rac2030/breakout-boards/README.md

# breakout-boards
Various breakoutboards for electronic components I play with
