rac2030/breakout-boards/ublox_NINA-W102/README.md

# ublox NINA-W102 breakout for breadboard prototyping
Project page with more information and background: http://rac.su/ninab

Hackaday Project entry: https://hackaday.io/project/151749-ublox-nina-w102-minimal-breakout

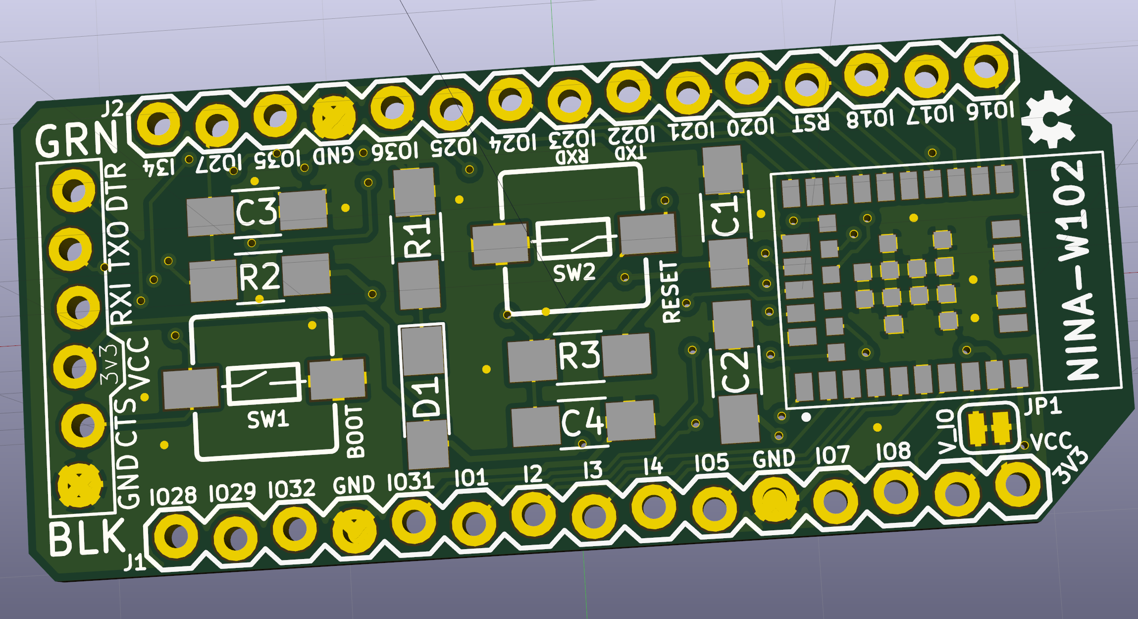
[picture p1: ublox_NINA-W102/images/NINA-W102_minimal_breakout-PCB.rev.0.3-3D-TOP.png]
3D Rendering

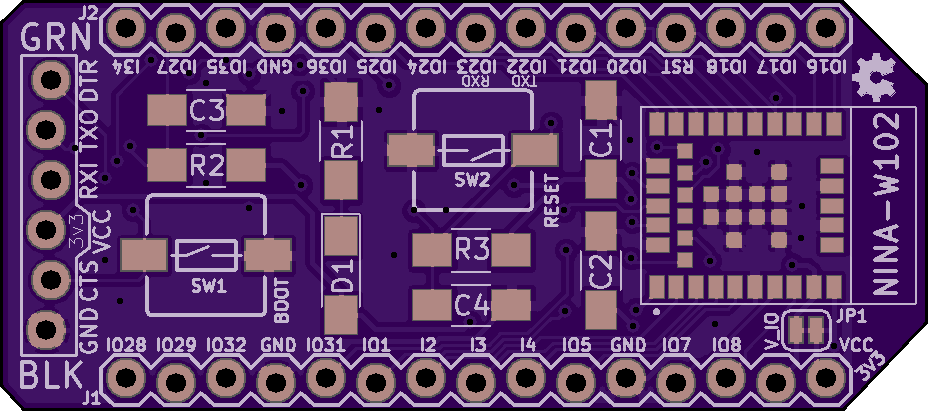
[picture p2: ublox_NINA-W102/images/NINA-W102_minimal_breakout-PCB.rev.0.3-OSHPark-TOP.png]
OSHPark TOP

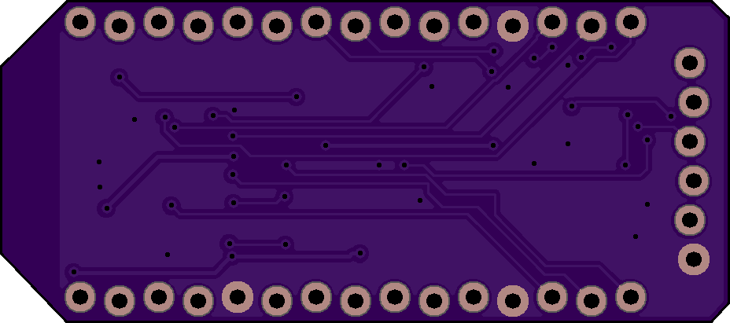
[picture p3: ublox_NINA-W102/images/NINA-W102_minimal_breakout-PCB.rev.0.3-OSHPark-BOTTOM.png]
OSHPark BOTTOM
