rac2030/breakout-boards/FPC-DIP_4PIN/README.md

# FPC connector breakout for breadboard prototyping
Created to play with Sensirion sensor samples on a Flex PCB for working on the software while the board design is still in progress. It is used with SMT FPC flip type connector from Ali ([Product I ordered](https://www.aliexpress.com/item/50pcs-FFC-FPC-Connector-4Pin-pitch-1-0mm-Flip-Type-Bottom-Contact/32655674440.html)) with 1.0mm pitch.
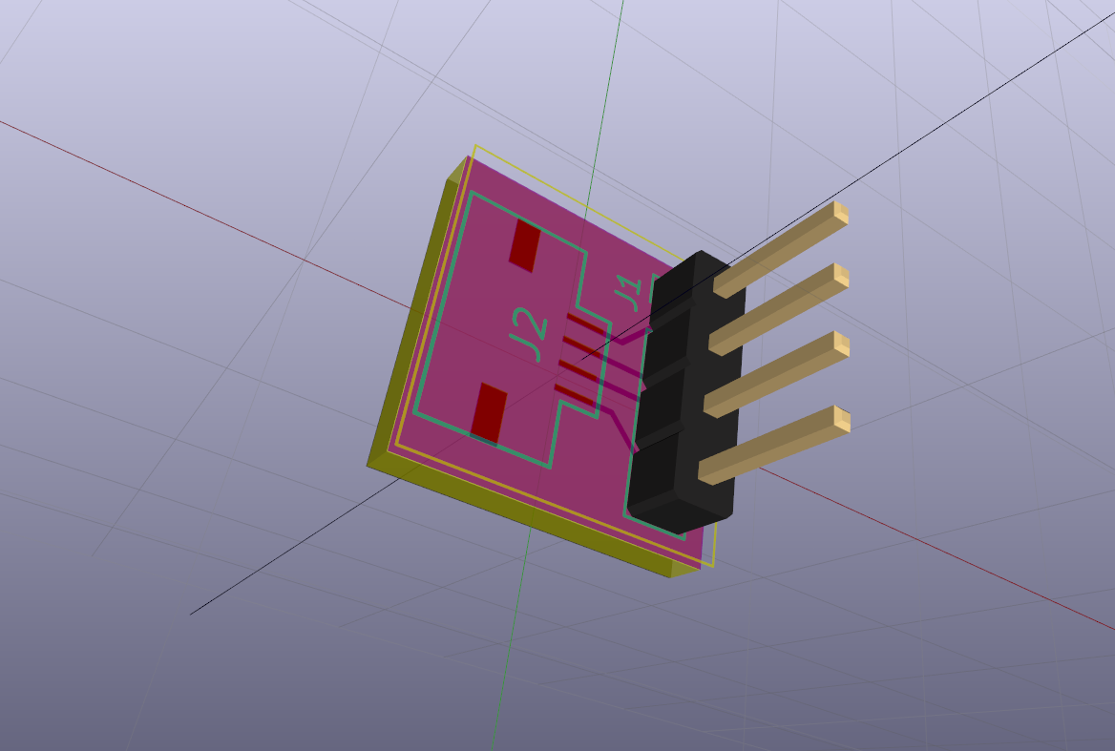
[picture p4: FPC-DIP_4PIN/FPC-DIP_4PIN.png]
3D Rendering


Rev. 0.1:
