rac2030/breakout-boards/ublox_NINA-W102/images/NINA-W102_minimal_breakout-PCB.rev.0.4-DIMENSION.png

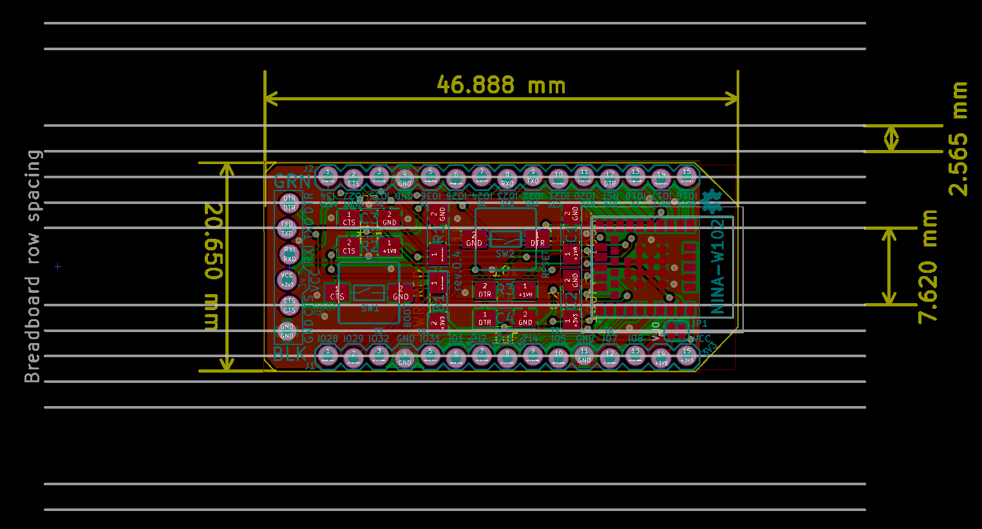
ublox_NINA-W102/images/NINA-W102_minimal_breakout-PCB.rev.0.4-DIMENSION.png
