rac2030/breakout-boards/ublox_NINA-W102/silkscreen/duck-tape-approved.png

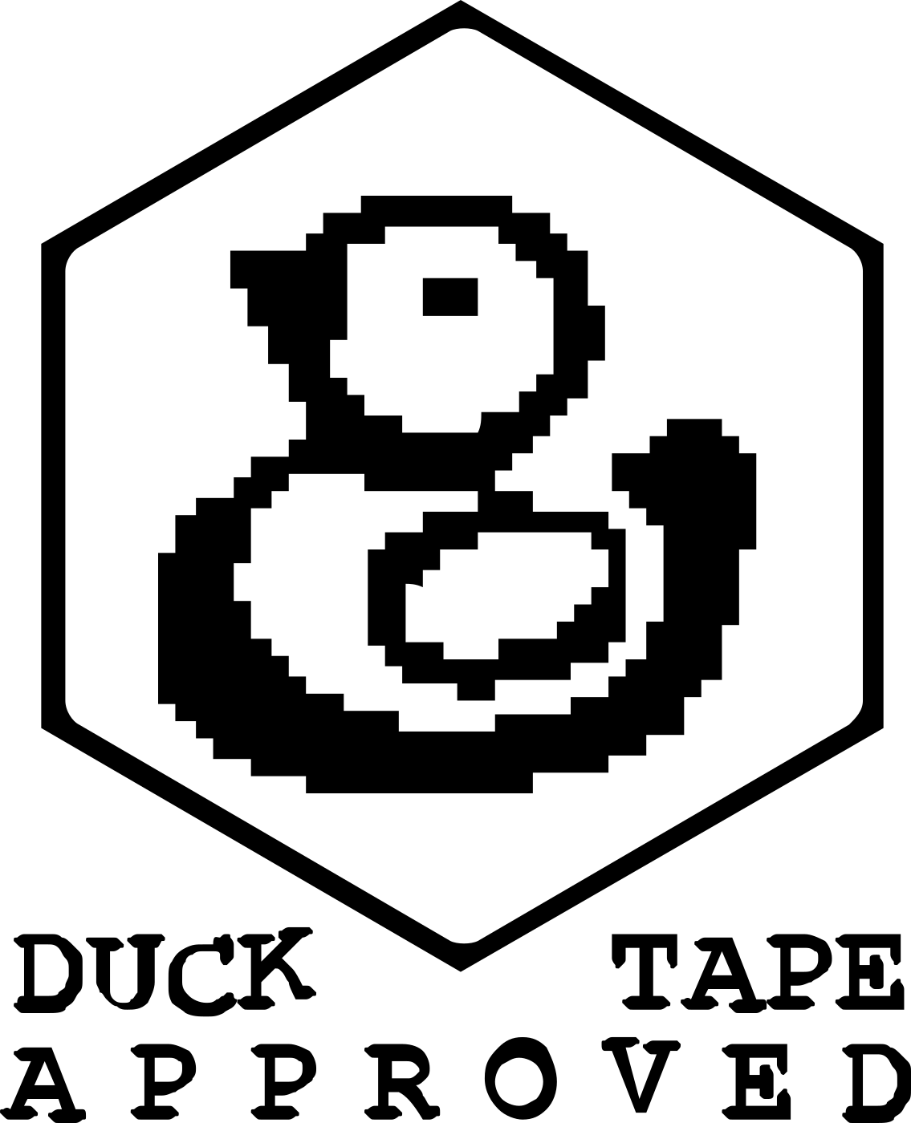
ublox_NINA-W102/silkscreen/duck-tape-approved.png
