rac2030/breakout-boards/ublox_NINA-W102/pinout/pinout-diagram.pdf

# http://rac.su/ninab CTS TXD RXD

### NINA-W102 Breakout

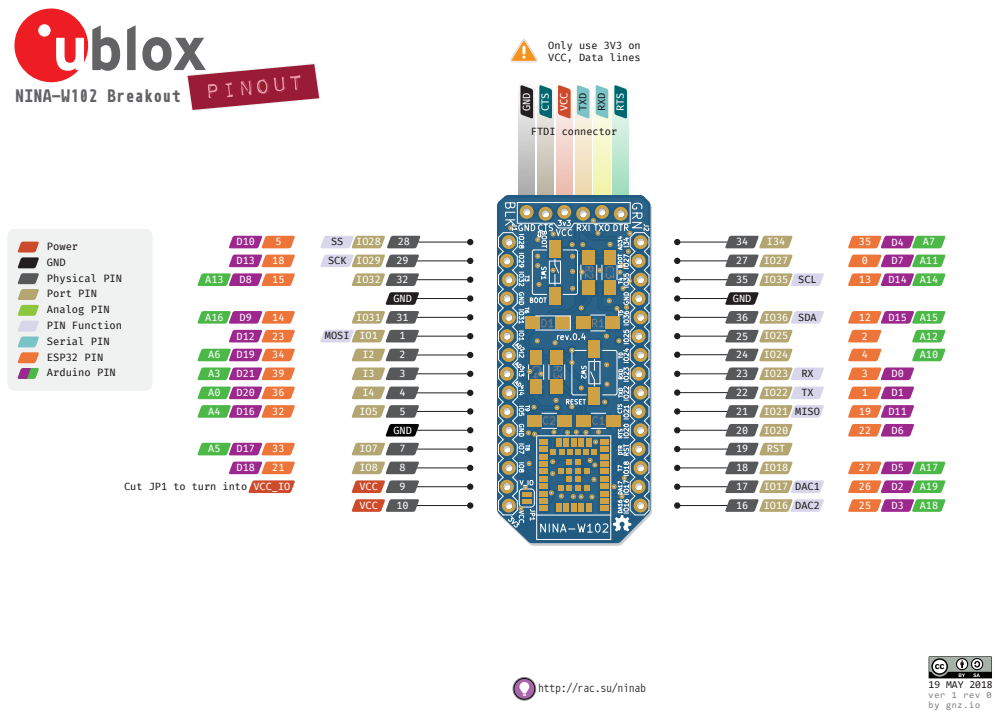
[picture p8: page 1]

Cut JP1 to turn into VCC_IO
