rac2030/breakout-boards/ublox_NINA-W102/NINA-W102_minimal_breakout-rev.0.5.pdf

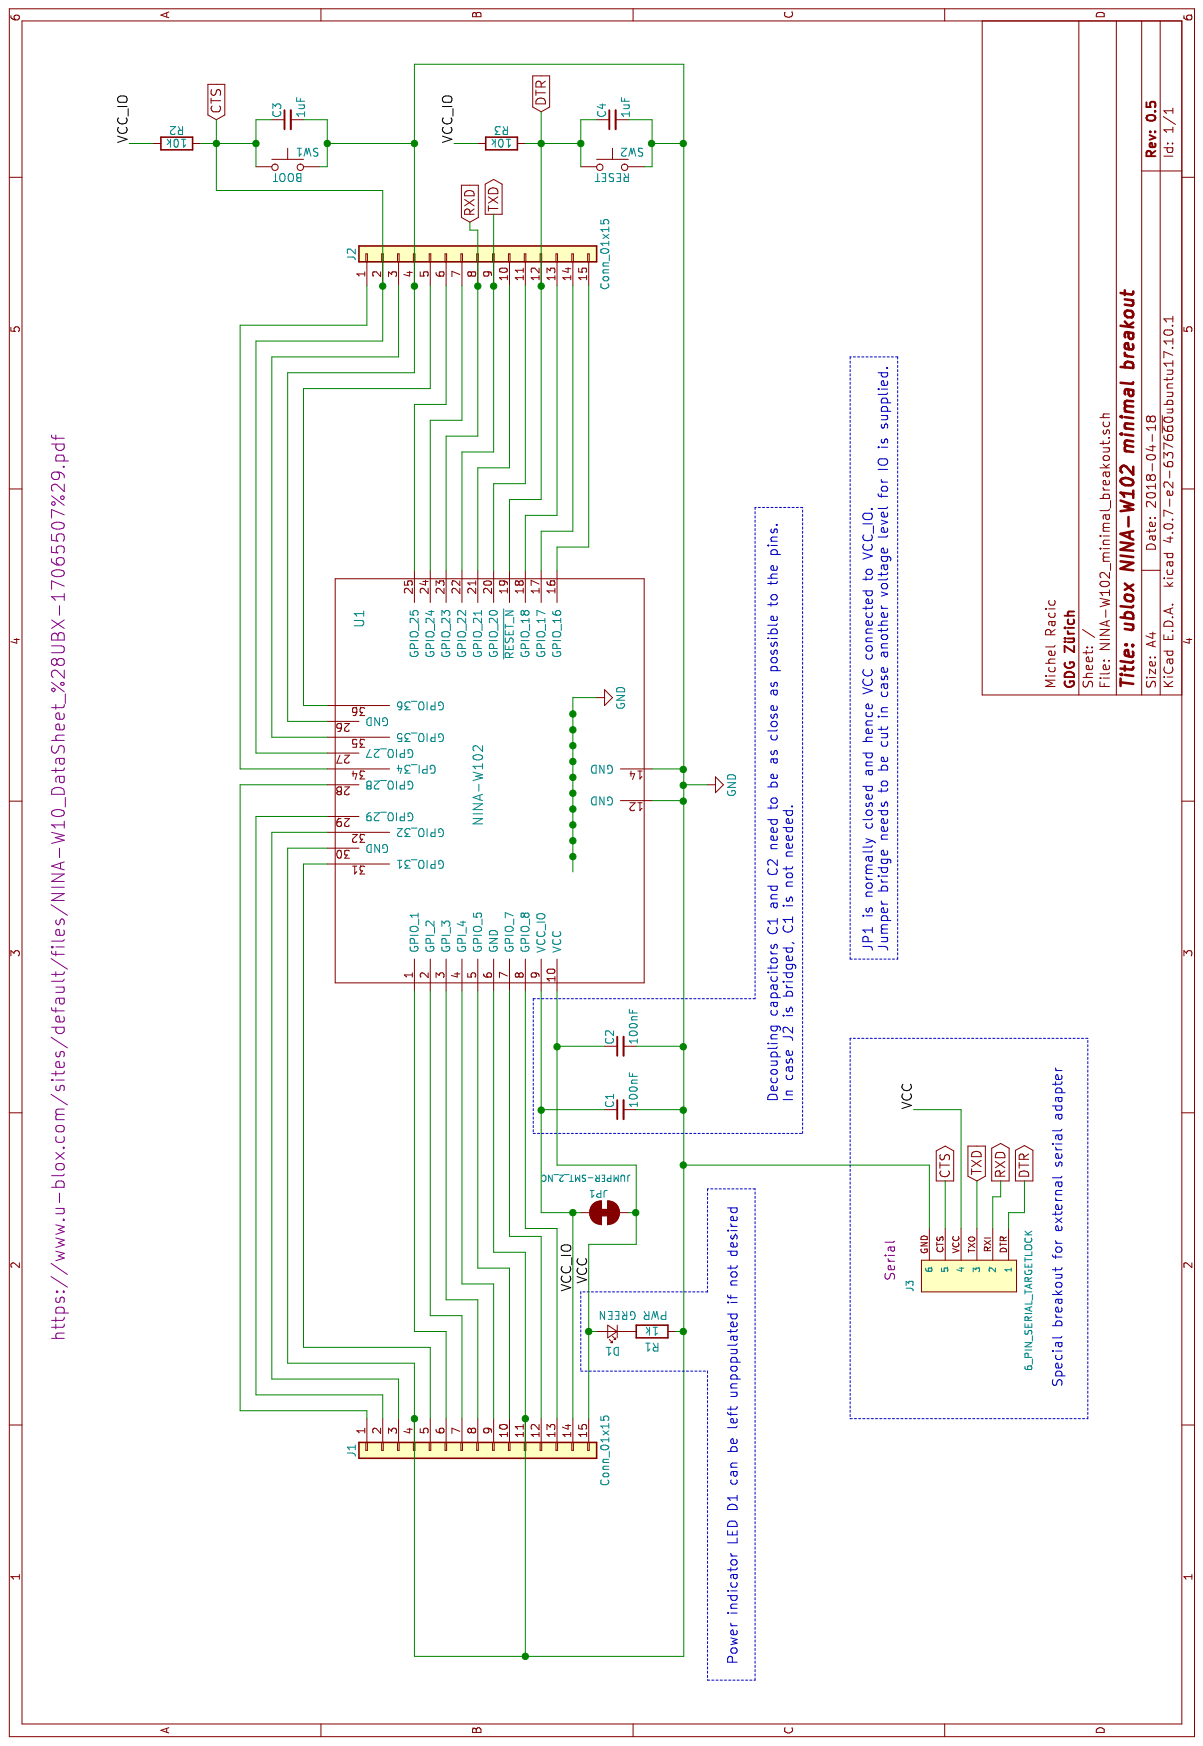
[picture p9: page 1]
