rac2030/breakout-boards/ublox_NINA-W102/NINA-W102_minimal_breakout-rev.0.4-PCB.pdf

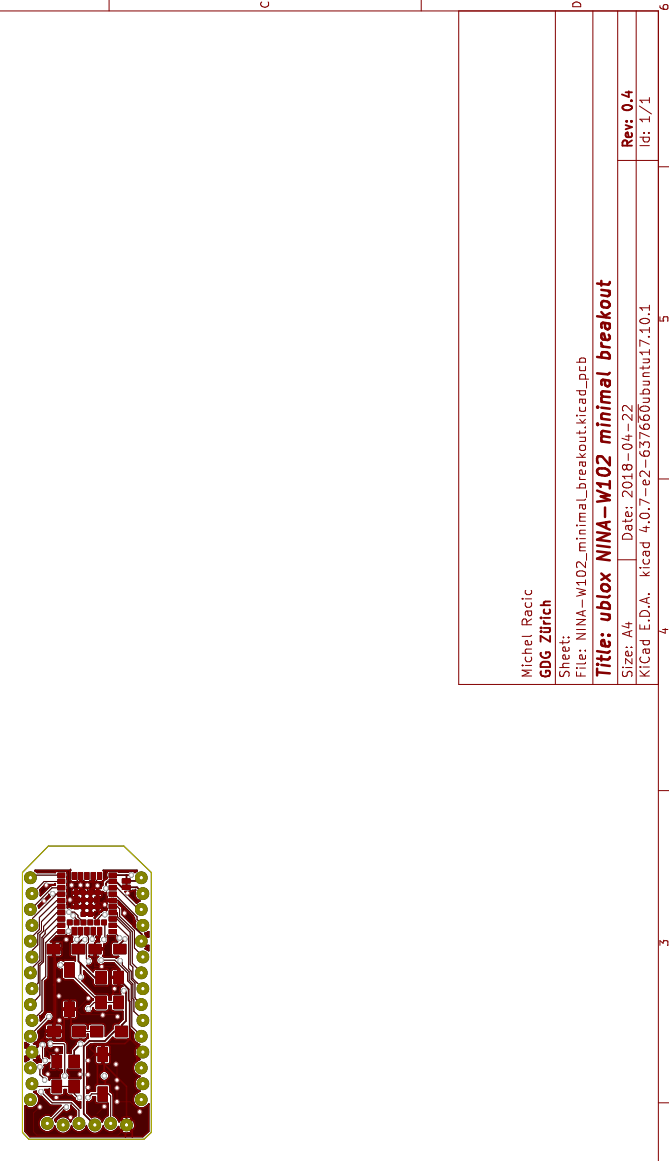
[picture p10: page 1]

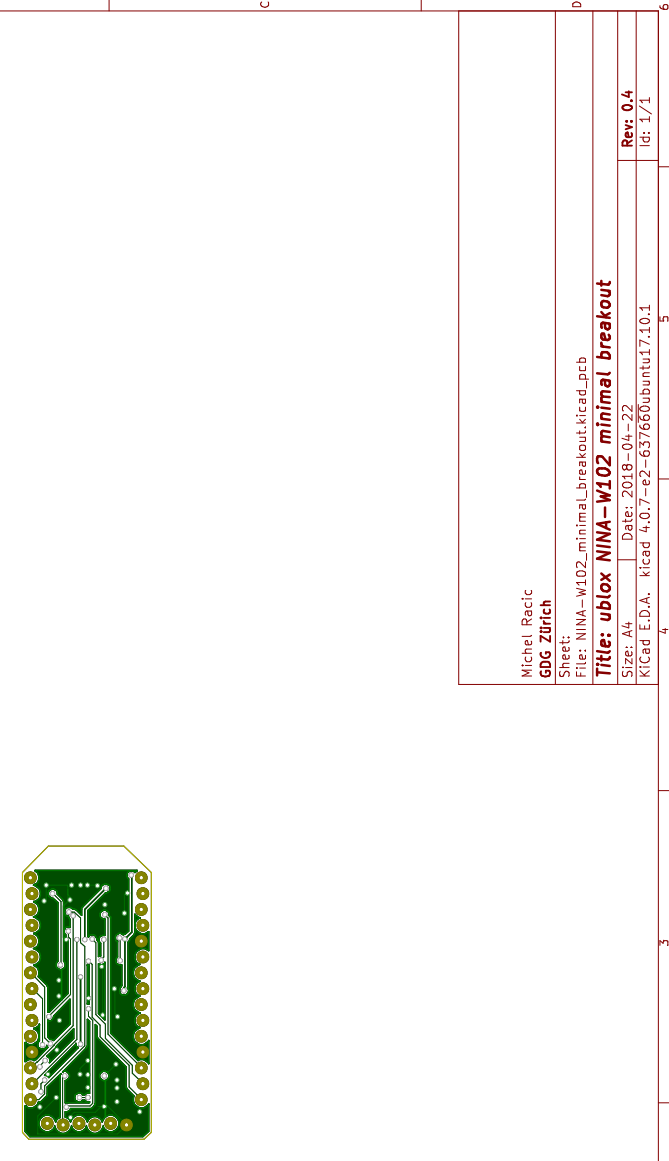
[picture p11: page 2]

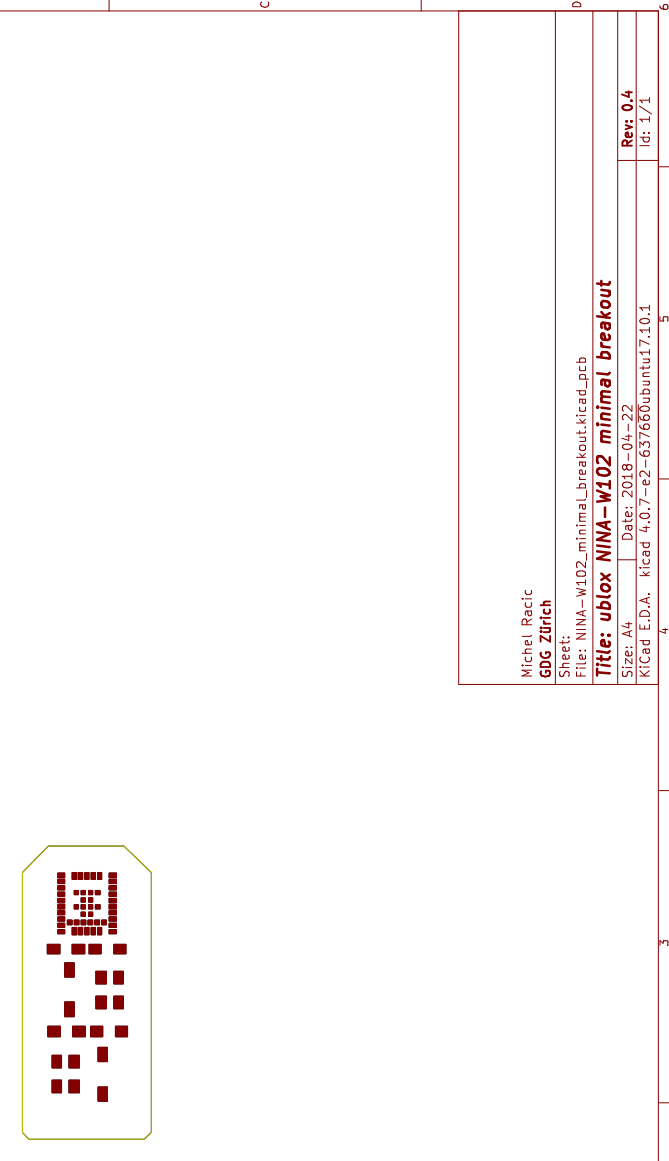
[picture p12: page 3]

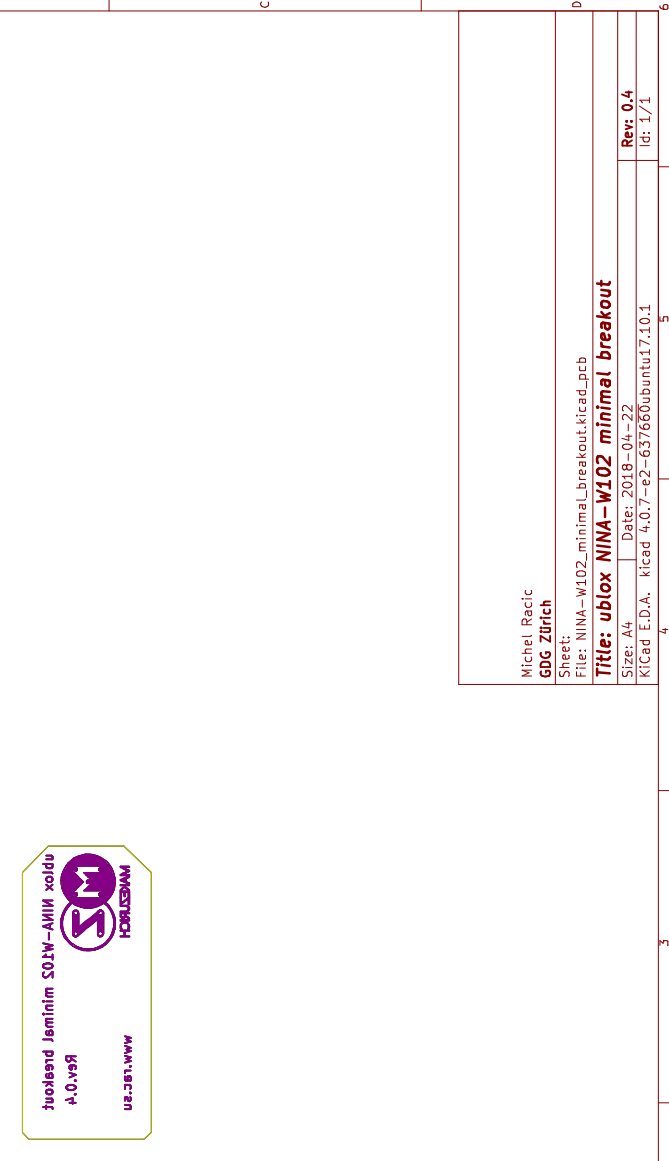
[picture p13: page 4]

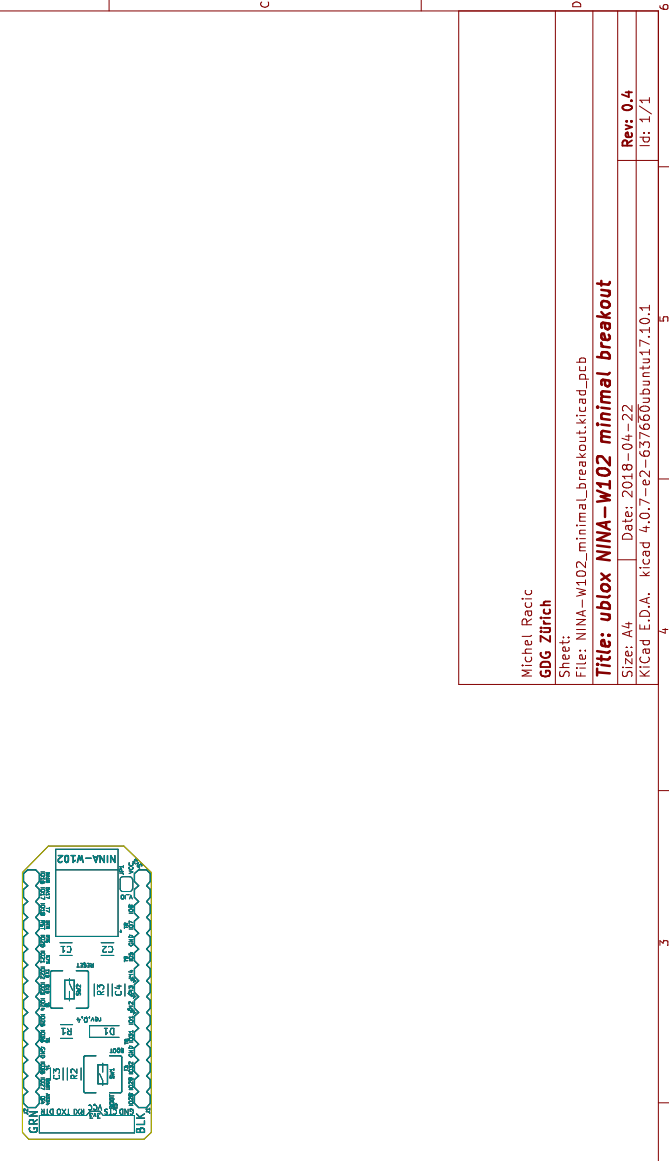
[picture p14: page 5]

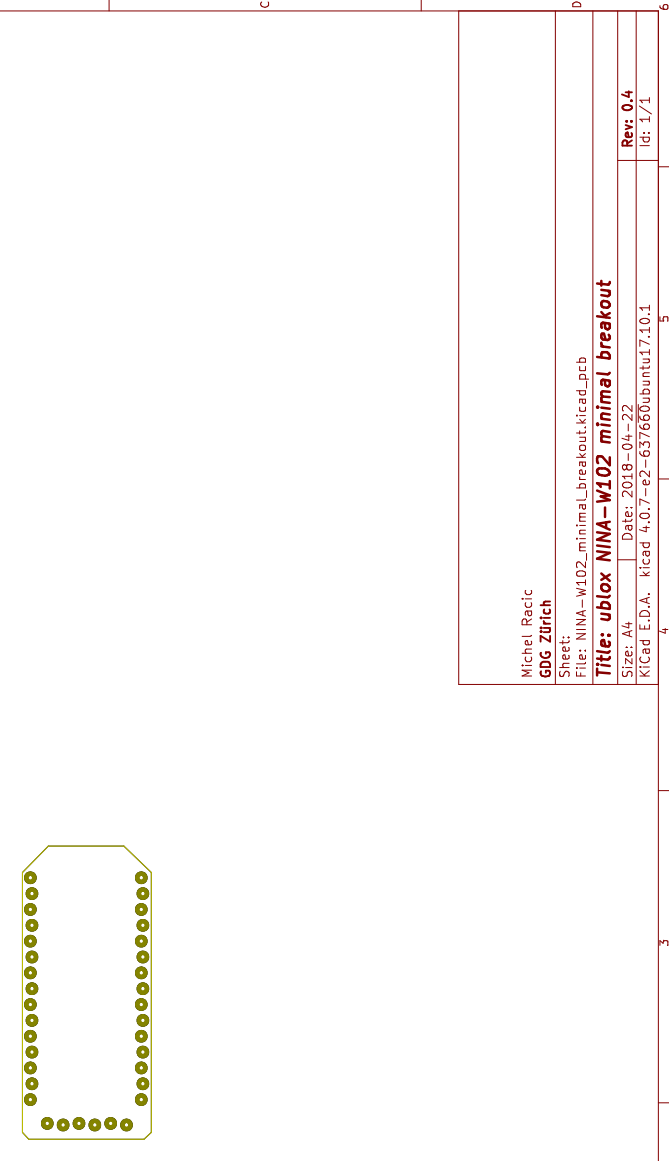
[picture p15: page 6]

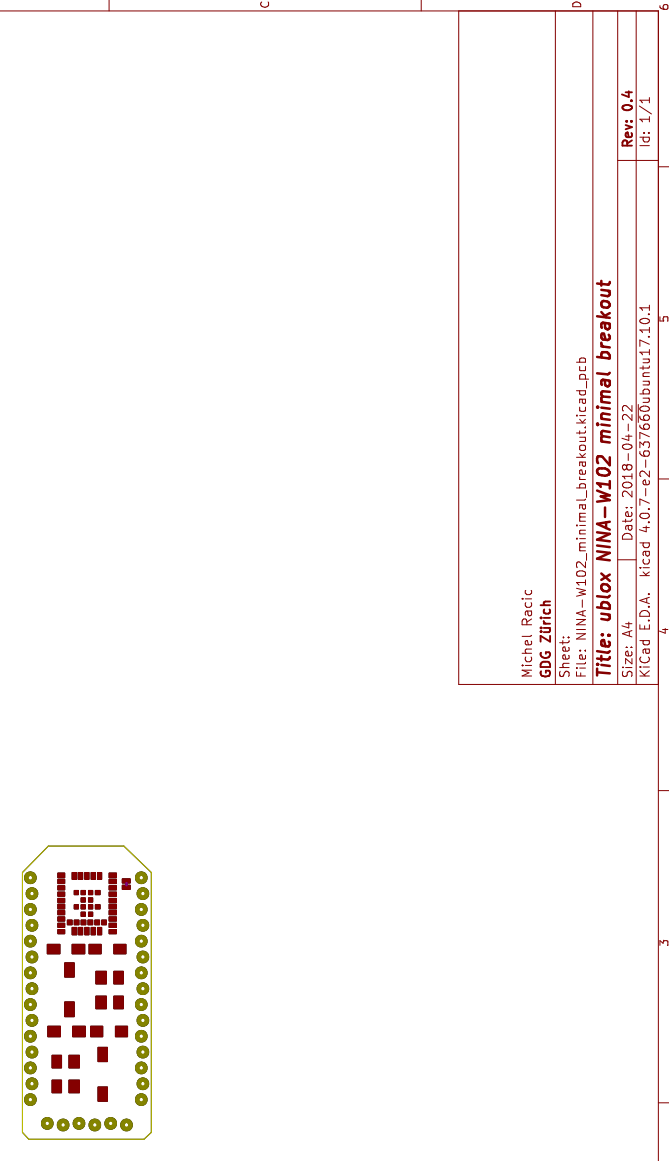
[picture p16: page 7]

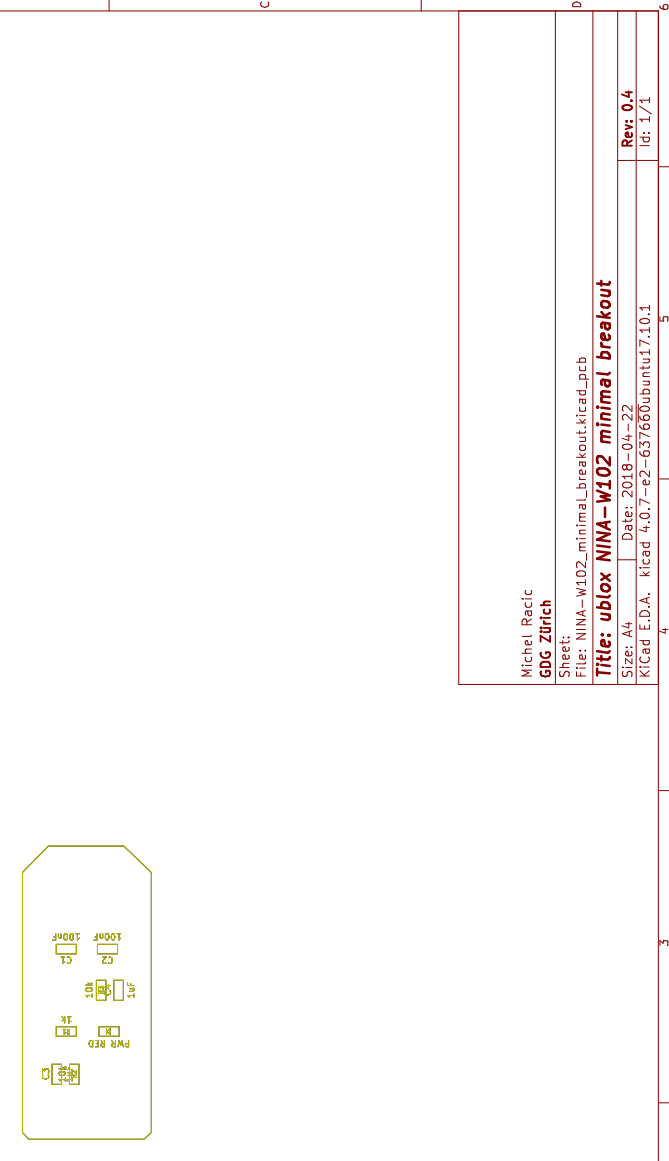
[picture p17: page 8]
