rac2030/breakout-boards/ublox_NINA-W102/NINA-W102_minimal_breakout-rev.0.4.pdf

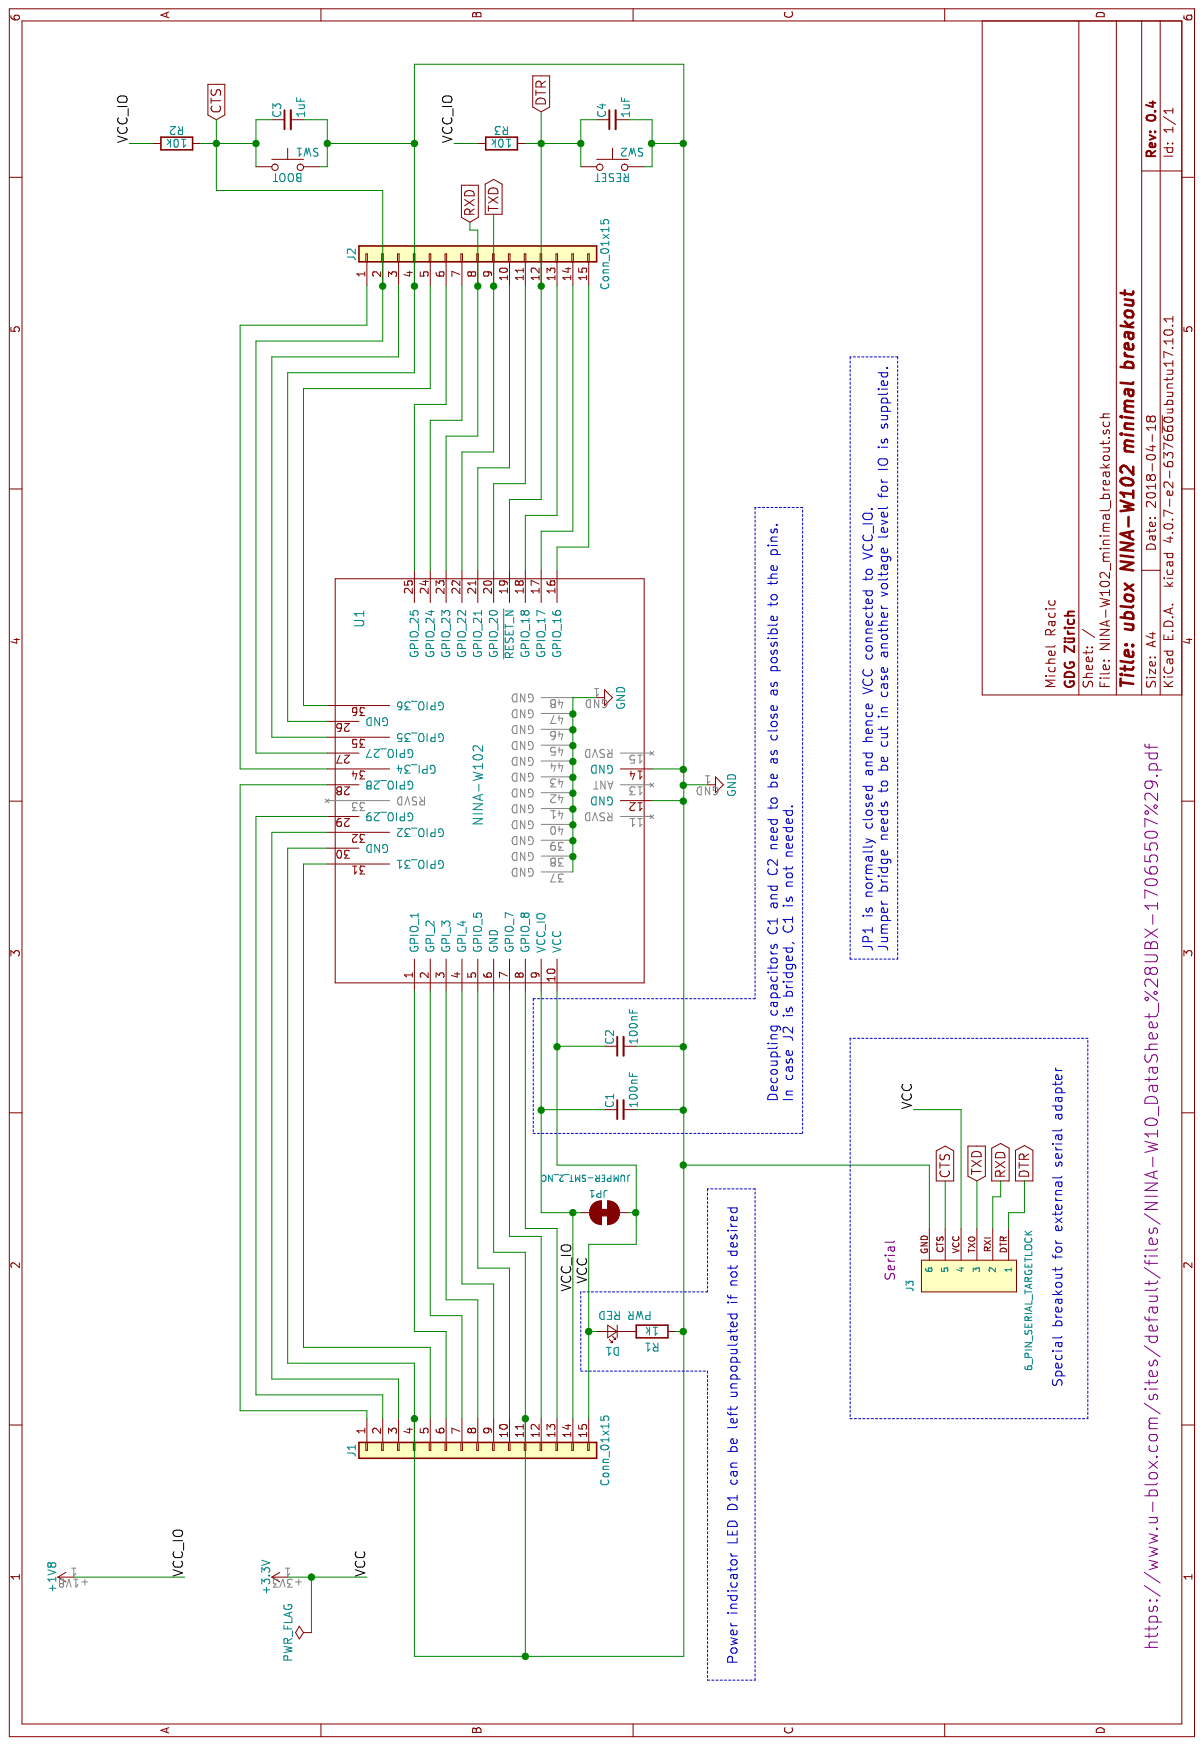
[picture p18: page 1]
