rac2030/breakout-boards/ublox_NINA-W102/NINA-W102_minimal_breakout-rev.0.3.pdf

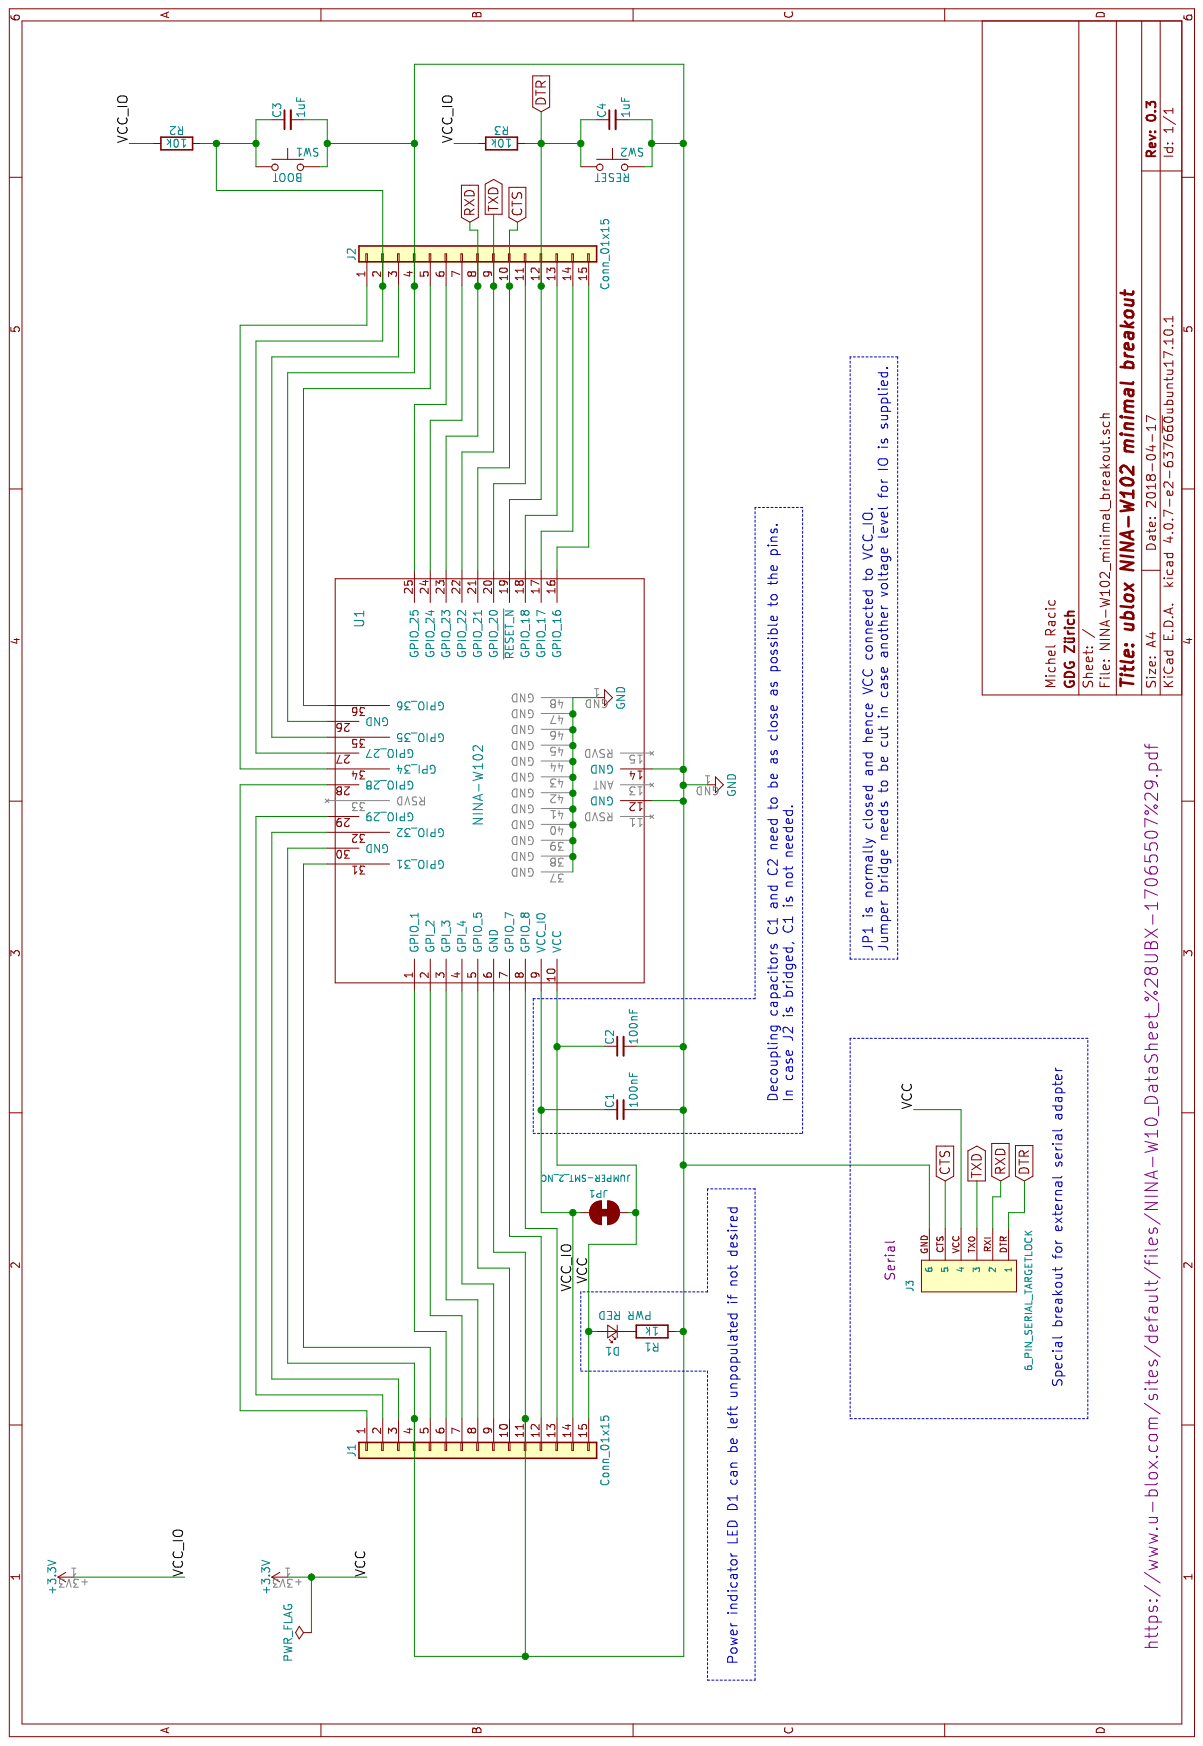
[picture p19: page 1]
