rac2030/breakout-boards/ublox_NINA-W102/NINA-W102_minimal_breakout.kicad_pcb

## KiCad design ublox_NINA-W102/NINA-W102_minimal_breakout.kicad_pcb (2018-05-29)

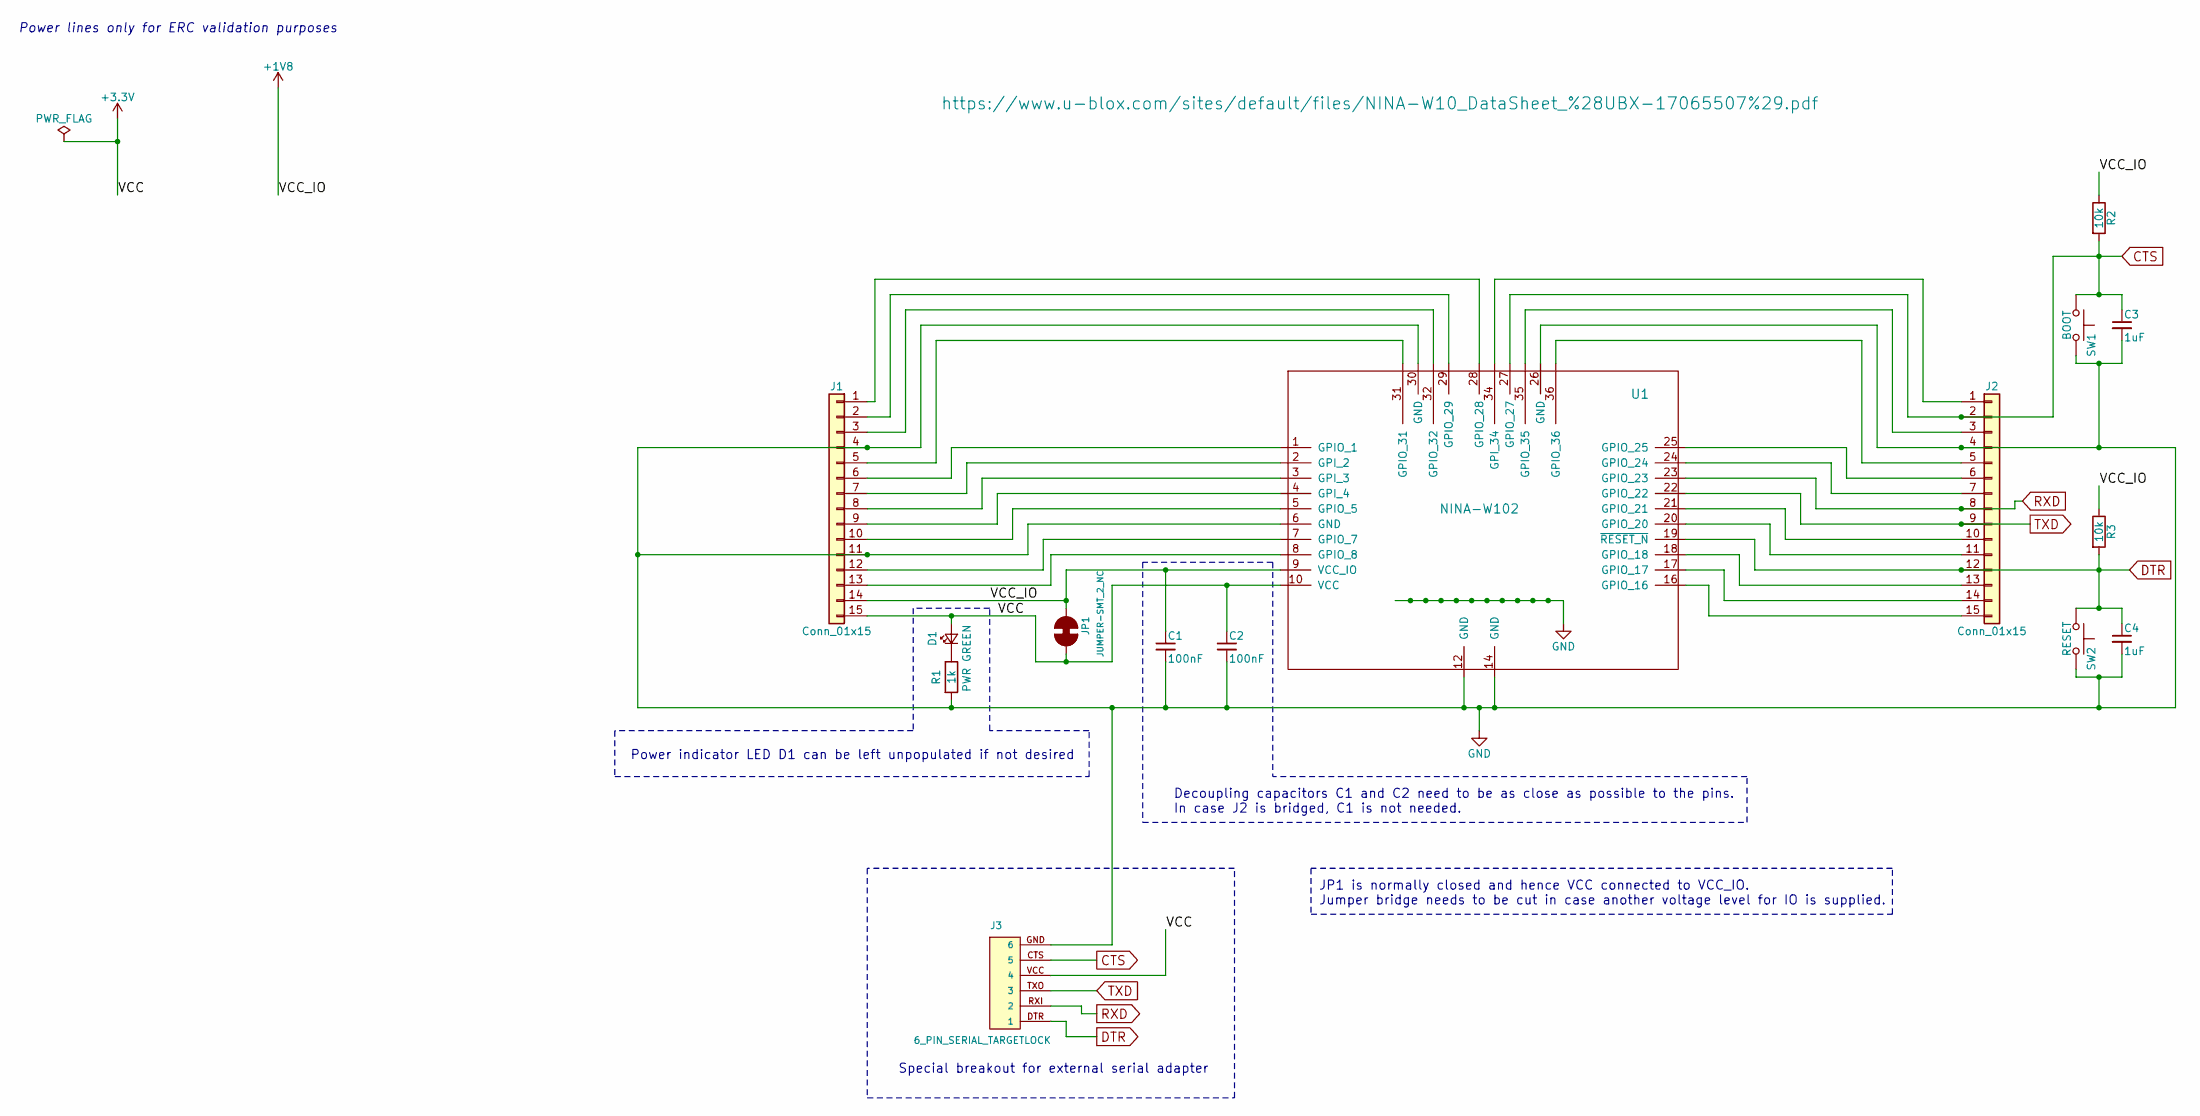
[picture p20: schematic NINA-W102_minimal_breakout.sch, ublox NINA-W102 minimal breakout]

Parts:
C1, C2: 100nF; C_1206_HandSoldering; Digikey 732-8086-1-ND
C3, C4: 1uF; C_1206_HandSoldering; Digikey 732-7692-1-ND
D1: PWR GREEN; LED_1206_HandSoldering; Digikey 732-5032-1-ND
J1, J2: Conn_01x15; 1X15_LOCK; Digikey WM50014-15-ND
J3: 6_PIN_SERIAL_TARGETLOCK; 6_PIN_SERIAL_TARGET_SIDE_W_SILK
JP1: JUMPER-SMT_2_NC; SMT-JUMPER_2_NC_TRACE_SILK
R1: 1k; R_1206_HandSoldering; Digikey 541-1.0KECT-ND
R2, R3: 10k; R_1206_HandSoldering; Digikey 541-4201-1-ND
SW1: BOOT; TACTILE_SWITCH_SMD_6.0X6.0MM; Digikey EG2663TR-ND
SW2: RESET; TACTILE_SWITCH_SMD_6.0X6.0MM; Digikey EG2663TR-ND
U1: NINA-W102; Digikey 672-1070-1-ND

Connections:
+1V8: C1.1, J1.14, JP1.1, R2.1, R3.1, U1.9 (VCC_IO)
+3V3: C2.1, D1.2 (A), J1.15, J3.VCC (4), JP1.2, U1.10 (VCC)
CTS: C3.1, J2.2, J3.CTS (5), R2.2, SW1.1, U1.27 (GPIO_27)
DTR: C4.1, J2.12, J3.DTR (1), R3.2, SW2.1, U1.19 (~RESET_N)
GND: C1.2, C2.2, C3.2, C4.2, J1.4, J1.11, J2.4, J3.GND (6), R1.2, SW1.2, SW2.2, U1.6 (GND), U1.12 (GND), U1.14 (GND), U1.26 (GND), U1.30 (GND), U1.37 (GND), U1.38 (GND), U1.39 (GND), U1.40 (GND), U1.41 (GND), U1.42 (GND), U1.43 (GND), U1.44 (GND), U1.45 (GND), U1.46 (GND), U1.47 (GND), U1.48 (GND)
unnamed: D1.1 (K), R1.1
unnamed: J1.1, U1.28 (GPIO_28)
unnamed: J1.2, U1.29 (GPIO_29)
unnamed: J1.3, U1.32 (GPIO_32)
unnamed: J1.5, U1.31 (GPIO_31)
unnamed: J1.6, U1.1 (GPIO_1)
unnamed: J1.7, U1.2 (GPI_2)
unnamed: J1.8, U1.3 (GPI_3)
unnamed: J1.9, U1.4 (GPI_4)
unnamed: J1.10, U1.5 (GPIO_5)
unnamed: J1.12, U1.7 (GPIO_7)
unnamed: J1.13, U1.8 (GPIO_8)
unnamed: J2.1, U1.34 (GPI_34)
unnamed: J2.3, U1.35 (GPIO_35)
unnamed: J2.5, U1.36 (GPIO_36)
unnamed: J2.6, U1.25 (GPIO_25)
unnamed: J2.7, U1.24 (GPIO_24)
unnamed: J2.10, U1.21 (GPIO_21)
unnamed: J2.11, U1.20 (GPIO_20)
unnamed: J2.13, U1.18 (GPIO_18)
unnamed: J2.14, U1.17 (GPIO_17)
unnamed: J2.15, U1.16 (GPIO_16)
RXD: J2.8, J3.RXI (2), U1.23 (GPIO_23)
TXD: J2.9, J3.TXO (3), U1.22 (GPIO_22)

Notes on the sheet:
Decoupling capacitors C1 and C2 need to be as close as possible to the pins. In case J2 is bridged, C1 is not needed.
Power indicator LED D1 can be left unpopulated if not desired
Special breakout for external serial adapter
JP1 is normally closed and hence VCC connected to VCC_IO. Jumper bridge needs to be cut in case another voltage level for IO is supplied.
Power lines only for ERC validation purposes

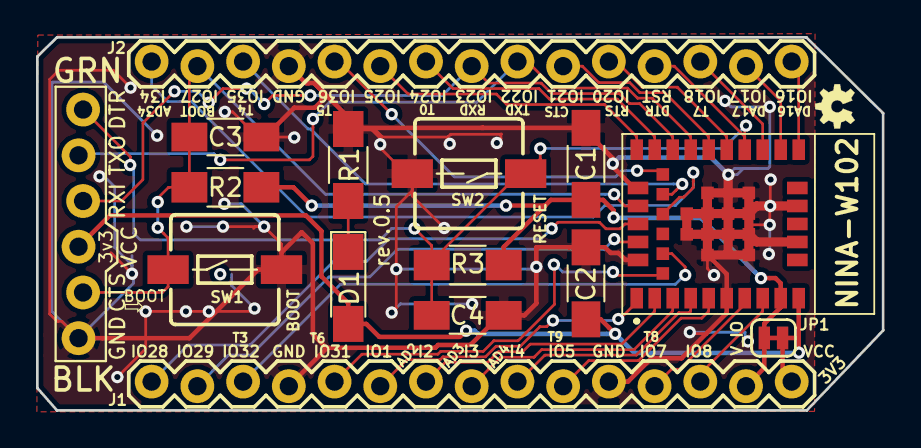
[picture p21: board NINA-W102_minimal_breakout.kicad_pcb from above]

Board: 2 copper layers, 47.0 x 20.7 mm, 16 parts (1 on the bottom side), 29 nets.

Other parts of the board:
MakeZurich-15x11-silk: G***; MakeZurich-15x11-silk
