rac2030/breakout-boards/(commit log)

2018-04-13 Added FPC breakout for sensirion samples
    [FPC-DIP_4PIN.kicad_pcb, FPC-DIP_4PIN.sch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]
2018-04-17 Added first version schematic
    [NINA-W102_minimal_breakout.kicad_pcb, NINA-W102_minimal_breakout.sch]
2018-04-17 Added printout for rev.0.3
2018-04-18 Fixed CTS PIN and added fpx sample mage from sensirion
    [FPC-DIP_4PIN.sch, NINA-W102_minimal_breakout.kicad_pcb, NINA-W102_minimal_breakout.sch]
2018-04-19 initial layout done without wiring
    [NINA-W102_minimal_breakout-routedtry1.kicad_pcb, NINA-W102_minimal_breakout.sch]
2018-04-19 First routing done
    [NINA-W102_minimal_breakout.kicad_pcb]
2018-04-19 Cleanup of leftover files
    [NINA-W102_minimal_breakout-routedtry1.kicad_pcb]
2018-04-19 First try with groundplane
    [NINA-W102_minimal_breakout.kicad_pcb]
2018-04-21 Rerouting and thickening power tracks to 10mils, integrating some of the feedback from Michael
    [NINA-W102_minimal_breakout.kicad_pcb]
2018-04-21 Added some ground pad vias and corrected placement of problematic vias as feedback from Michael Ammann
    [NINA-W102_minimal_breakout.kicad_pcb]
2018-04-21 Added rendering images of PCB rev.0.3
2018-04-21 Corrected solder mask on Jumper that the trace will be easy cuttable
    [NINA-W102_minimal_breakout.kicad_pcb]
2018-04-22 Added revision info on front PCB
    [NINA-W102_minimal_breakout.kicad_pcb]
2018-04-22 Added some silk labels for pins from datasheet
    [NINA-W102_minimal_breakout.kicad_pcb]
2018-04-22 Added missing AD pin label
    [NINA-W102_minimal_breakout.kicad_pcb]
2018-04-22 Added dimensions and updated revision
    [NINA-W102_minimal_breakout.kicad_pcb]
2018-04-22 Simplified some tracks to look nicer
    [NINA-W102_minimal_breakout.kicad_pcb]
2018-04-22 Did rerun DRC
    [NINA-W102_minimal_breakout.kicad_pcb]
2018-04-22 Added some ground vias
    [NINA-W102_minimal_breakout.kicad_pcb]
2018-04-22 Additions and changes to the labeling
    [NINA-W102_minimal_breakout.kicad_pcb]
2018-04-22 Added some MakeZurich artwork
    [NINA-W102_minimal_breakout.kicad_pcb]
2018-04-23 DuckTape approved stamp and track angle corrections and some more ground vias
    [NINA-W102_minimal_breakout.kicad_pcb]
2018-04-24 Added GND pad and labels for sensirion sample flex PCBs
    [FPC-DIP_4PIN.kicad_pcb, FPC-DIP_4PIN.sch]
2018-04-24 Added china I2C layout version for Urs Marti
    [FPC-DIP_4PIN-chinaI2C.kicad_pcb, FPC-DIP_4PIN-chinaI2C.sch]
2018-05-03 Added printouts and BOM
    [NINA-W102_minimal_breakout.sch]
2018-05-03 Added schematic components to local library
    [NINA-W102_minimal_breakout.sch]
2018-05-03 Removed external schematic libraries
    [NINA-W102_minimal_breakout.sch]
2018-05-03 Added footprints to local library and reassigned in schematic
    [NINA-W102_minimal_breakout.kicad_pcb, NINA-W102_minimal_breakout.sch]
2018-05-21 Change duck tape silkscreen for licensed one ;)
    [NINA-W102_minimal_breakout.kicad_pcb]
2018-05-21 Corrected silk and added GDG logo
    [NINA-W102_minimal_breakout.kicad_pcb]
2018-05-29 Changed schematics to current PCB revision and added all digikey partnumbers visible in the BOM html output
    [NINA-W102_minimal_breakout.sch]
2018-05-29 Fixed breadboard spacing helper component position
    [NINA-W102_minimal_breakout.kicad_pcb]
2018-06-21 Added manufacturing output and corrected I2C issue with the badge carrier board
    [NINA-W102_minimal_breakout.sch]
